TweetyDaBird/RefleXion-65/PCB/README.md

# RefleXion X65

# Change Log:
- v1.00 - Initial Prototype
  - Never released.

- v1.10 - First Release
  - Total redesign for onboard RP2040 MCU
  
- v1.15 - Second Prototype
  - Never Released.
  
- v1.20 - Second Release
  - Refactored USB footprint.
  - Refactored encoder footprints.
  - Refactored switch footprints with reinforced pads(larger via).
  - Added RGB selection from Glow to Per-Key with switch.
  - Added solder/jumper to select thumb RGB layout.
