TweetyDaBird/RefleXion-65/PCB/v1.20/bom/README.md

# Interactive BOM
To view the interactive bom, use the html preview link here: http://htmlpreview.github.io/?https://github.com/TweetyDaBird/RefleXion-65/blob/main/PCB/v1.20/bom/ibom.html
