TweetyDaBird/RefleXion-65/PCB/v1.20/_restore_backup_2026-09-21T10-17-14-011/RefleXion X65.kicad_pcb

## KiCad design PCB/v1.20/_restore_backup_2026-09-21T10-17-14-011/RefleXion X65.kicad_pcb (2026-11-10)

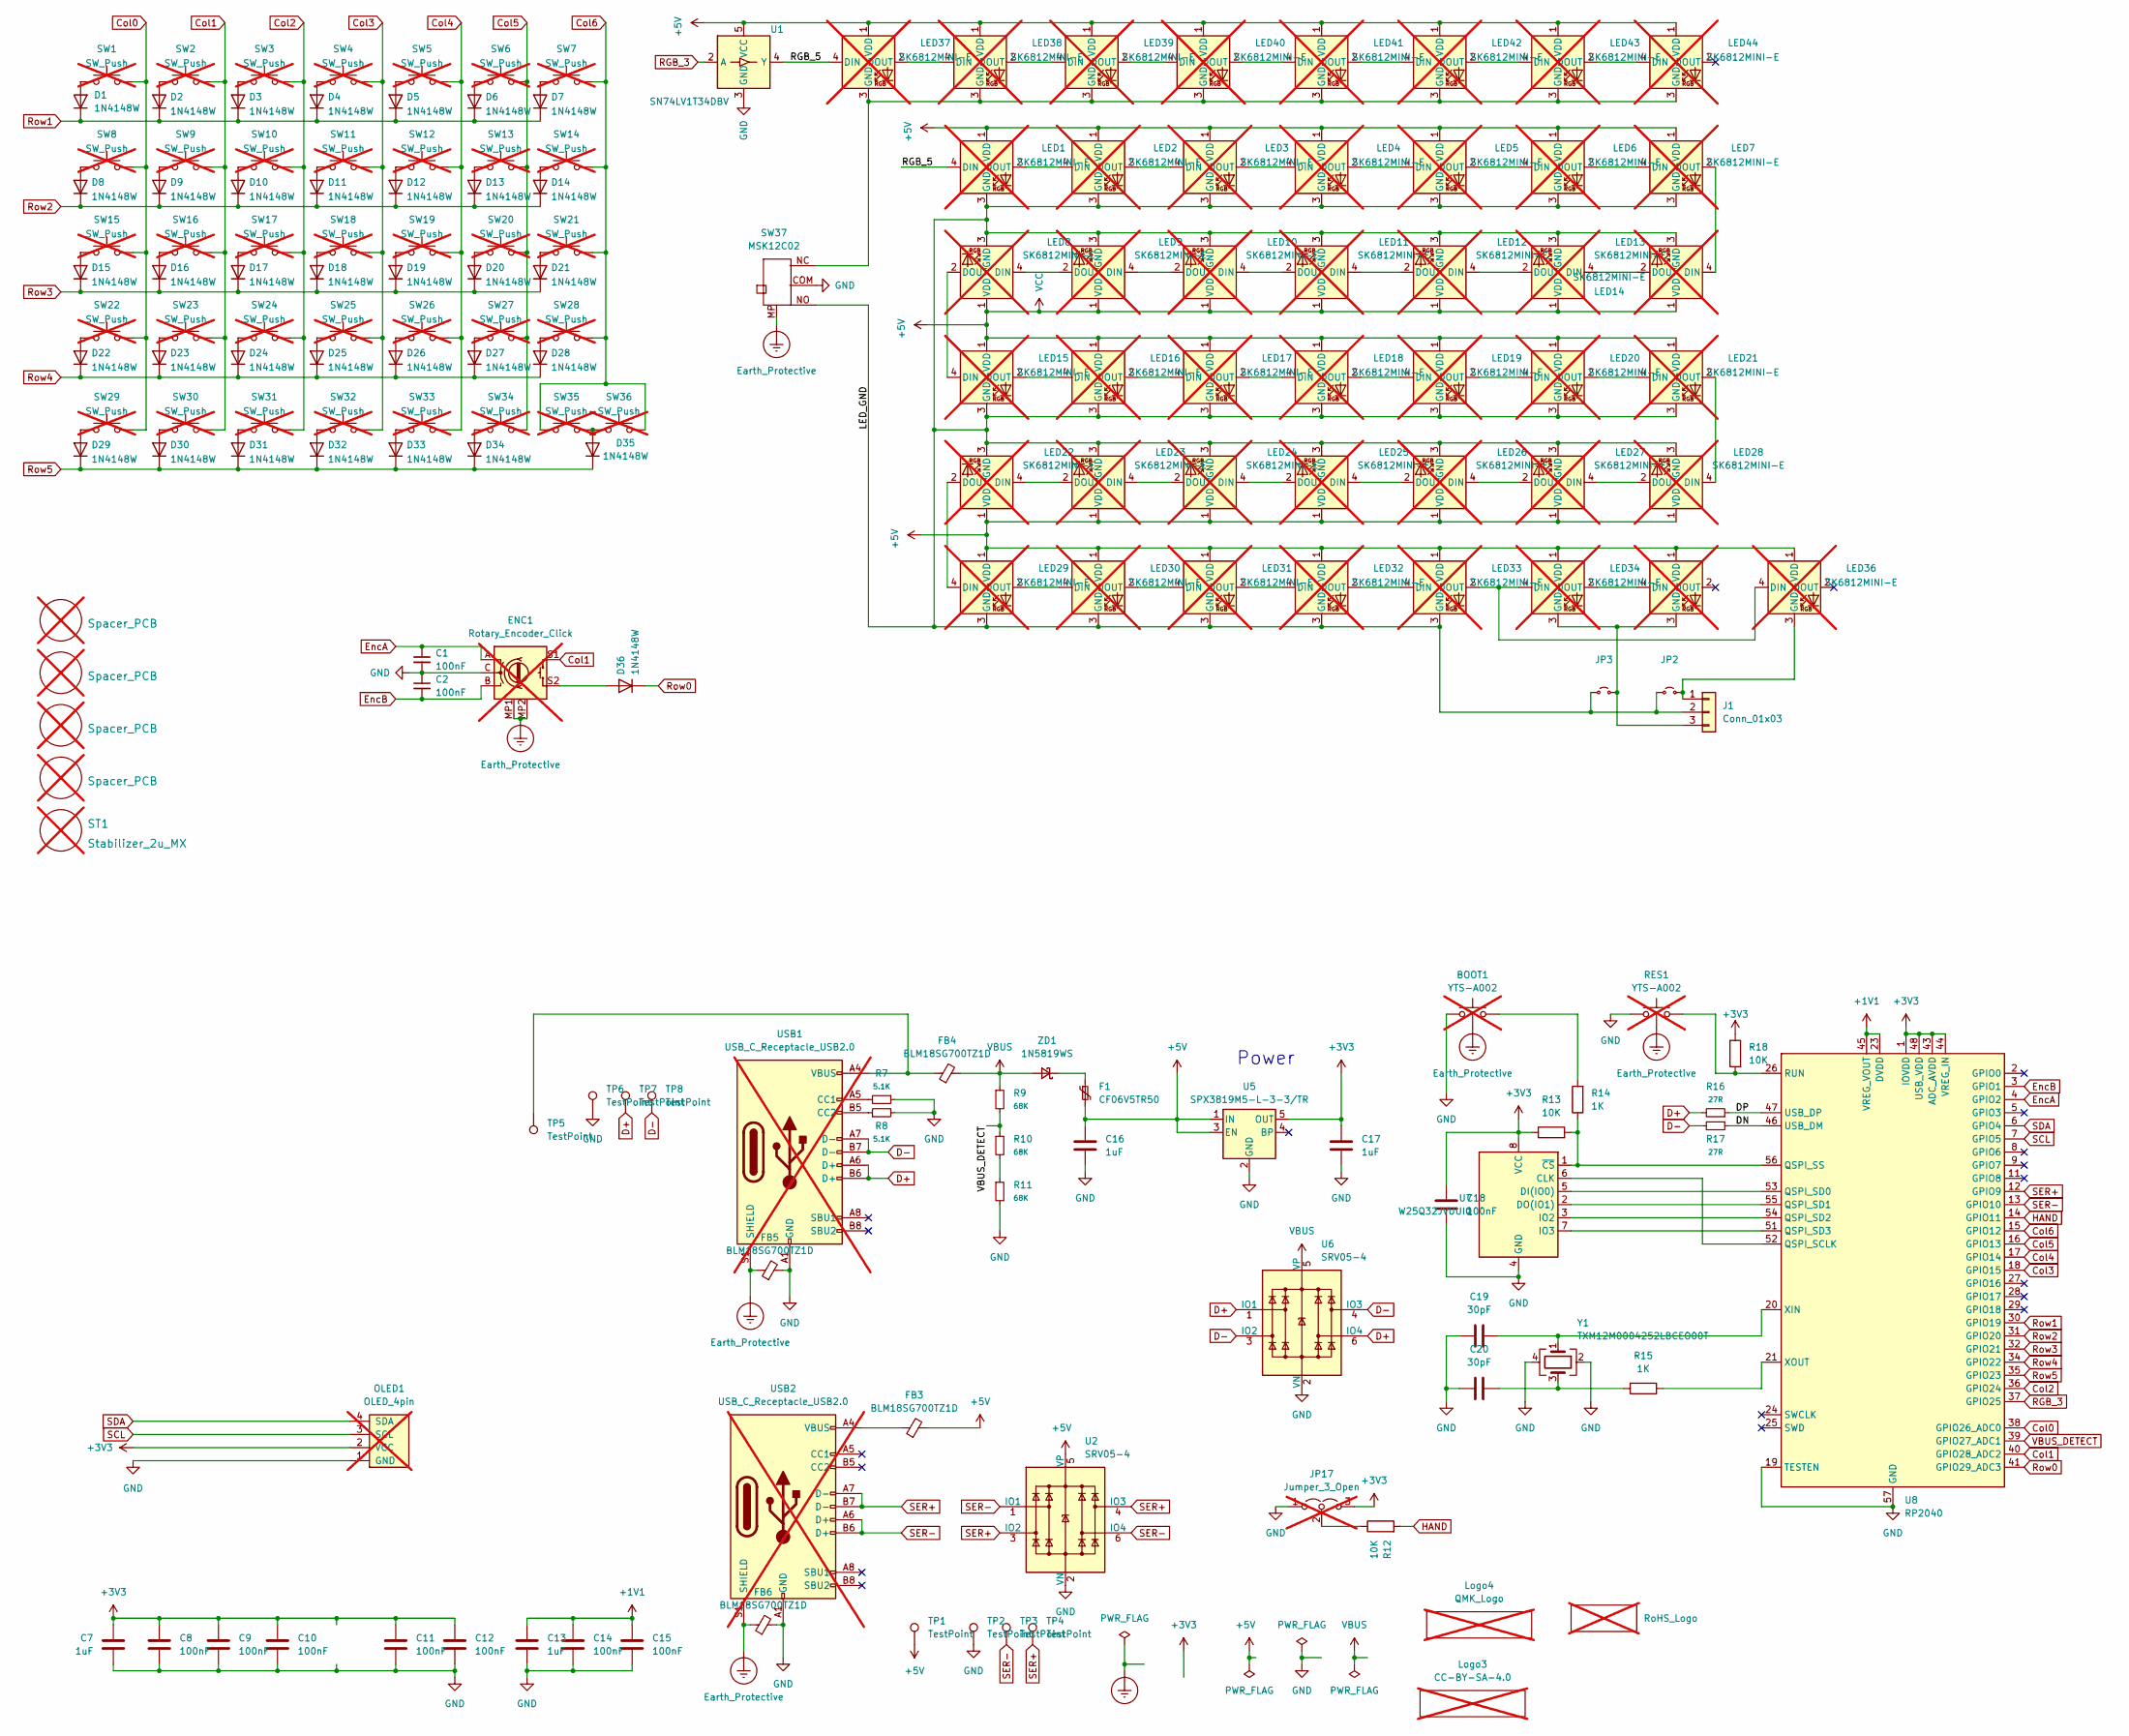
[picture p1: schematic RefleXion X65.kicad_sch]

Parts:
BOOT1: YTS-A002; LCSC C2910650; not fitted
C1, C2, C8, C9, C10, C11, C12, C14, C15, C18: 100nF; C_0402_1005Metric; LCSC C1525
C7, C13, C16, C17: 1uF; C_0402_1005Metric; LCSC C52923
C19, C20: 30pF; C_0402_1005Metric; LCSC C1570
D1, D2, D3, D4, D5, D6, D7, D8, D9, D10, D11, D12, D13, D14, D15, D16, D17, D18, D19, D20, D21, D22, D23, D24, D25, D26, D27, D28, D29, D30, D31, D32, D33, D34, D35, D36: 1N4148W; D_SOD-323_HandSoldering; LCSC C81598
ENC1: Rotary_Encoder_Click; Encoder_Alps_EC11E_Small; not fitted
F1: CF06V5TR50; R_0603_1608Metric; LCSC C163116
FB3, FB4, FB5, FB6: BLM18SG700TZ1D; C_0603_1608Metric_Pad1.08x0.95mm_HandSolder; LCSC C1002
H1, H2, H3, H4: Spacer_PCB; Spacer PCB hole; not fitted
J1: Conn_01x03; PinHeader_1x03_P1.27mm_Horizontal
JP2, JP3: Jumper_2_Small_Open; Jumper_min_v2
JP17: Jumper_3_Open; SolderJumper-3_open_mini; not fitted
LED1, LED2, LED3, LED4, LED5, LED6, LED7, LED8, LED9, LED10, LED11, LED12, LED13, LED14, LED15, LED16, LED17, LED18, LED19, LED20, LED21, LED22, LED23, LED24, LED25, LED26, LED27, LED28, LED29, LED30, LED31, LED32, LED33: SK6812MINI-E; MX_SK6812MINI-E_REVERSIBLE; not fitted
LED34, LED35, LED36, LED37, LED38, LED39, LED40, LED41, LED42, LED43, LED44: SK6812MINI-E; MX_SK6812MINI-E_REVERSIBLE_special; not fitted
Logo1: RoHS_Logo; RoHs; not fitted
Logo3: CC-BY-SA-4.0; CC_BY_SA_40_line; not fitted
Logo4: QMK_Logo; Powered_by_QMK; not fitted
OLED1: OLED_4pin; SSD1306-0.91-OLED-4pin-128x32 doublesided; not fitted
R7, R8: 5.1K; R_0402_1005Metric; LCSC C25905
R9, R10, R11: 68K; R_0402_1005Metric; LCSC C137947
R12, R13, R18: 10K; R_0402_1005Metric; LCSC C25744
R14, R15: 1K; R_0402_1005Metric; LCSC C11702
R16, R17: 27R; R_0402_1005Metric; LCSC C321419
RES1: YTS-A002; LCSC C2910650; not fitted
ST1: Stabilizer_2u_MX; Stabilizer_Cherry_MX_2.00u; not fitted
SW1, SW2, SW3, SW4, SW5, SW6, SW7, SW8, SW9, SW10, SW11, SW12, SW13, SW14, SW15, SW16, SW17, SW18, SW19, SW20, SW21, SW22, SW23, SW24, SW25, SW26, SW27, SW28, SW29, SW30, SW31, SW32, SW33, SW34, SW35, SW36: SW_Push; SW_MX_HotSwap_Reversible_reinforced; not fitted
SW37: MSK12C02
TP1, TP2, TP3, TP4, TP5, TP6, TP7, TP8: TestPoint; TestPoint_Pad_D1.0mm
U1: SN74LV1T34DBV; SOT-23-5; LCSC C100024
U2, U6: SRV05-4; SOT-23-6; LCSC C7420376
U5: SPX3819M5-L-3-3/TR; SOT-23-5; LCSC C9055
U7: W25Q32JVUUIQ; USON-8_4x3mm_P0.8mm; LCSC C2999380
U8: RP2040; QFN-56-1EP_7x7mm_P0.4mm_EP3.2x3.2mm_ThermalVias; LCSC C2040
USB1: USB_C_Receptacle_USB2.0; HRO_TYPE-C-31-M-12_double_sided; LCSC C963373; not fitted
USB2: USB_C_Receptacle_USB2.0; HRO_TYPE-C-31-M-12_double_sided_serial link; LCSC C963373; not fitted
Y1: TXM12M0004252LBCEO00T; Crystal_SMD_2520-4Pin_2.5x2.0mm; LCSC C284156
ZD1: 1N5819WS; D_SOD-323F; LCSC C191023

Connections:
+1V1: C13.1, C14.1, C15.1, U8.23 (DVDD), U8.45 (VREG_VOUT), U8.50 (DVDD)
+3V3: C7.1, C8.1, C9.1, C10.1, C11.1, C12.1, C17.1, C18.1, JP17.3 (B), OLED1.2 (VCC), R13.1, R18.1, U5.5 (OUT), U7.8 (VCC), U8.1 (IOVDD), U8.10 (IOVDD), U8.22 (IOVDD), U8.33 (IOVDD), U8.42 (IOVDD), U8.43 (ADC_AVDD), U8.44 (VREG_IN), U8.48 (USB_VDD), U8.49 (IOVDD)
+5V: C16.1, F1.2, FB3.2, LED1.1 (VDD), LED2.1 (VDD), LED3.1 (VDD), LED4.1 (VDD), LED5.1 (VDD), LED6.1 (VDD), LED7.1 (VDD), LED8.1 (VDD), LED9.1 (VDD), LED10.1 (VDD), LED11.1 (VDD), LED12.1 (VDD), LED13.1 (VDD), LED14.1 (VDD), LED15.1 (VDD), LED16.1 (VDD), LED17.1 (VDD), LED18.1 (VDD), LED19.1 (VDD), LED20.1 (VDD), LED21.1 (VDD), LED22.1 (VDD), LED23.1 (VDD), LED24.1 (VDD), LED25.1 (VDD), LED26.1 (VDD), LED27.1 (VDD), LED28.1 (VDD), LED29.1 (VDD), LED30.1 (VDD), LED31.1 (VDD), LED32.1 (VDD), LED33.1 (VDD), LED34.1 (VDD), LED35.1 (VDD), LED36.1 (VDD), LED37.1 (VDD), LED38.1 (VDD), LED39.1 (VDD), LED40.1 (VDD), LED41.1 (VDD), LED42.1 (VDD), LED43.1 (VDD), LED44.1 (VDD), TP1.1 (1_1), U1.5 (VCC), U2.5 (VP), U5.1 (IN), U5.3 (EN)
/DN: R17.1, U8.46 (USB_DM)
/DP: R16.1, U8.47 (USB_DP)
/LED_GND: J1.2, JP2.1 (A), JP3.1 (A), LED1.3 (GND), LED2.3 (GND), LED3.3 (GND), LED4.3 (GND), LED5.3 (GND), LED6.3 (GND), LED7.3 (GND), LED8.3 (GND), LED9.3 (GND), LED10.3 (GND), LED11.3 (GND), LED12.3 (GND), LED13.3 (GND), LED14.3 (GND), LED15.3 (GND), LED16.3 (GND), LED17.3 (GND), LED18.3 (GND), LED19.3 (GND), LED20.3 (GND), LED21.3 (GND), LED22.3 (GND), LED23.3 (GND), LED24.3 (GND), LED25.3 (GND), LED26.3 (GND), LED27.3 (GND), LED28.3 (GND), LED29.3 (GND), LED30.3 (GND), LED31.3 (GND), LED32.3 (GND), LED33.3 (GND), SW37.NO
/RGB_5: LED1.4 (DIN), LED37.4 (DIN), U1.4 (Y)
Col0: SW1.1, SW8.1, SW15.1, SW22.1, SW29.1, U8.38 (GPIO26_ADC0)
Col1: ENC1.S1, SW2.2, SW9.2, SW16.2, SW23.2, SW30.2, U8.40 (GPIO28_ADC2)
Col2: SW3.2, SW10.2, SW17.2, SW24.2, SW31.2, U8.36 (GPIO24)
Col3: SW4.2, SW11.2, SW18.2, SW25.2, SW32.2, U8.18 (GPIO15)
Col4: SW5.2, SW12.2, SW19.2, SW26.2, SW33.2, U8.17 (GPIO14)
Col5: SW6.2, SW13.2, SW20.2, SW27.2, SW34.2, U8.16 (GPIO13)
Col6: SW7.2, SW14.2, SW21.2, SW28.2, SW35.1, SW36.2, U8.15 (GPIO12)
D+: R16.2, TP7.1 (1_1), U6.1 (IO1), U6.6 (IO4), USB1.A6 (D+), USB1.B6 (D+)
D-: R17.2, TP8.1 (1_1), U6.3 (IO2), U6.4 (IO3), USB1.A7 (D-), USB1.B7 (D-)
Earth_Protective: BOOT1.3, ENC1.MP1 (GND), ENC1.MP2 (GND), FB5.1, FB6.1, RES1.3, SW37.MP (GND), USB1.S1 (SHIELD), USB2.S1 (SHIELD)
Enc1: D1.2 (A), SW1.2
Enc2: D7.2 (A), SW7.1
EncA: C1.1, ENC1.A, U8.4 (GPIO2)
EncB: C2.2, ENC1.B, U8.3 (GPIO1)
GND: BOOT1.2, C1.2, C2.1, C7.2, C8.2, C9.2, C10.2, C11.2, C12.2, C13.2, C14.2, C15.2, C16.2, C17.2, C18.2, C19.2, C20.2, ENC1.C, FB5.2, FB6.2, JP17.1 (A), OLED1.1 (GND), R7.1, R8.2, R11.2, RES1.1, SW37.COM, TP2.1 (1_1), TP6.1 (1_1), U1.3 (GND), U2.2 (VN), U5.2 (GND), U6.2 (VN), U7.4 (GND), U8.19 (TESTEN), U8.57 (GND), USB1.A1 (GND), USB1.A12 (GND), USB1.B1 (GND), USB1.B12 (GND), USB2.A1 (GND), USB2.A12 (GND), USB2.B1 (GND), USB2.B12 (GND), Y1.2, Y1.4
HAND: R12.2, U8.14 (GPIO11)
unnamed: BOOT1.1, R14.2
unnamed: C20.1, R15.2, Y1.3
unnamed: D2.2 (A), SW2.1
unnamed: D3.2 (A), SW3.1
unnamed: D4.2 (A), SW4.1
unnamed: D5.2 (A), SW5.1
unnamed: D6.2 (A), SW6.1
unnamed: D8.2 (A), SW8.2
unnamed: D9.2 (A), SW9.1
unnamed: D10.2 (A), SW10.1
unnamed: D11.2 (A), SW11.1
unnamed: D12.2 (A), SW12.1
unnamed: D13.2 (A), SW13.1
unnamed: D14.2 (A), SW14.1
unnamed: D15.2 (A), SW15.2
unnamed: D16.2 (A), SW16.1
unnamed: D17.2 (A), SW17.1
unnamed: D18.2 (A), SW18.1
unnamed: D19.2 (A), SW19.1
unnamed: D20.2 (A), SW20.1
unnamed: D21.2 (A), SW21.1
unnamed: D22.2 (A), SW22.2
unnamed: D23.2 (A), SW23.1
unnamed: D24.2 (A), SW24.1
unnamed: D25.2 (A), SW25.1
unnamed: D26.2 (A), SW26.1
unnamed: D27.2 (A), SW27.1
unnamed: D28.2 (A), SW28.1
unnamed: D29.2 (A), SW29.2
unnamed: D30.2 (A), SW30.1
unnamed: D31.2 (A), SW31.1
unnamed: D32.2 (A), SW32.1
unnamed: D33.2 (A), SW33.1
unnamed: D34.2 (A), SW34.1
unnamed: D35.2 (A), SW35.2, SW36.1
unnamed: D36.2 (A), ENC1.S2
unnamed: FB3.1, USB2.A4 (VBUS), USB2.A9 (VBUS), USB2.B4 (VBUS), USB2.B9 (VBUS)
unnamed: FB4.1, TP5.1 (1_1), USB1.A4 (VBUS), USB1.A9 (VBUS), USB1.B4 (VBUS), USB1.B9 (VBUS)
unnamed: J1.1, JP2.2 (B), LED36.3 (GND)
unnamed: J1.3, JP3.2 (B), LED34.3 (GND), LED35.3 (GND)
unnamed: JP17.2 (C), R12.1
unnamed: LED1.2 (DOUT), LED2.4 (DIN)
unnamed: LED2.2 (DOUT), LED3.4 (DIN)
unnamed: LED3.2 (DOUT), LED4.4 (DIN)
unnamed: LED4.2 (DOUT), LED5.4 (DIN)
unnamed: LED5.2 (DOUT), LED6.4 (DIN)
unnamed: LED6.2 (DOUT), LED7.4 (DIN)
unnamed: LED8.4 (DIN), LED9.2 (DOUT)
unnamed: LED10.4 (DIN), LED11.2 (DOUT)
unnamed: LED9.4 (DIN), LED10.2 (DOUT)
unnamed: LED11.4 (DIN), LED12.2 (DOUT)
unnamed: LED12.4 (DIN), LED13.2 (DOUT)
unnamed: LED13.4 (DIN), LED14.2 (DOUT)
unnamed: LED7.2 (DOUT), LED14.4 (DIN)
unnamed: LED8.2 (DOUT), LED15.4 (DIN)
unnamed: LED15.2 (DOUT), LED16.4 (DIN)
unnamed: LED16.2 (DOUT), LED17.4 (DIN)
unnamed: LED17.2 (DOUT), LED18.4 (DIN)
unnamed: LED18.2 (DOUT), LED19.4 (DIN)
unnamed: LED19.2 (DOUT), LED20.4 (DIN)
unnamed: LED20.2 (DOUT), LED21.4 (DIN)
unnamed: LED21.2 (DOUT), LED28.4 (DIN)
unnamed: LED22.4 (DIN), LED23.2 (DOUT)
unnamed: LED22.2 (DOUT), LED29.4 (DIN)
unnamed: LED23.4 (DIN), LED24.2 (DOUT)
unnamed: LED24.4 (DIN), LED25.2 (DOUT)
unnamed: LED25.4 (DIN), LED26.2 (DOUT)
unnamed: LED26.4 (DIN), LED27.2 (DOUT)
unnamed: LED27.4 (DIN), LED28.2 (DOUT)
unnamed: LED29.2 (DOUT), LED30.4 (DIN)
unnamed: LED30.2 (DOUT), LED31.4 (DIN)
unnamed: LED31.2 (DOUT), LED32.4 (DIN)
unnamed: LED32.2 (DOUT), LED33.4 (DIN)
unnamed: LED33.2 (DOUT), LED34.4 (DIN), LED36.4 (DIN)
unnamed: LED34.2 (DOUT), LED35.4 (DIN)
unnamed: LED37.2 (DOUT), LED38.4 (DIN)
unnamed: LED37.3 (GND), LED38.3 (GND), LED39.3 (GND), LED40.3 (GND), LED41.3 (GND), LED42.3 (GND), LED43.3 (GND), LED44.3 (GND), SW37.NC
unnamed: LED38.2 (DOUT), LED39.4 (DIN)
unnamed: LED39.2 (DOUT), LED40.4 (DIN)
unnamed: LED40.2 (DOUT), LED41.4 (DIN)
unnamed: LED41.2 (DOUT), LED42.4 (DIN)
unnamed: LED42.2 (DOUT), LED43.4 (DIN)
unnamed: LED43.2 (DOUT), LED44.4 (DIN)
unnamed: R10.2, R11.1
unnamed: U7.6 (CLK), U8.52 (QSPI_SCLK)
unnamed: U7.5 (DI(IO0)), U8.53 (QSPI_SD0)
unnamed: U7.2 (DO(IO1)), U8.55 (QSPI_SD1)
unnamed: U7.3 (IO2), U8.54 (QSPI_SD2)
unnamed: U7.7 (IO3), U8.51 (QSPI_SD3)
unnamed: R13.2, R14.1, U7.1 (~CS), U8.56 (QSPI_SS)
unnamed: R18.2, RES1.2, U8.26 (RUN)
unnamed: C19.1, U8.20 (XIN), Y1.1
unnamed: R15.1, U8.21 (XOUT)
unnamed: R7.2, USB1.A5 (CC1)
unnamed: R8.1, USB1.B5 (CC2)
unnamed: F1.1, ZD1.1 (K)
RGB_3: U1.2 (A), U8.37 (GPIO25)
Row0: D36.1 (K), U8.41 (GPIO29_ADC3)
Row1: D1.1 (K), D2.1 (K), D3.1 (K), D4.1 (K), D5.1 (K), D6.1 (K), D7.1 (K), U8.30 (GPIO19)
Row2: D8.1 (K), D9.1 (K), D10.1 (K), D11.1 (K), D12.1 (K), D13.1 (K), D14.1 (K), U8.31 (GPIO20)
Row3: D15.1 (K), D16.1 (K), D17.1 (K), D18.1 (K), D19.1 (K), D20.1 (K), D21.1 (K), U8.32 (GPIO21)
Row4: D22.1 (K), D23.1 (K), D24.1 (K), D25.1 (K), D26.1 (K), D27.1 (K), D28.1 (K), U8.34 (GPIO22)
Row5: D29.1 (K), D30.1 (K), D31.1 (K), D32.1 (K), D33.1 (K), D34.1 (K), D35.1 (K), U8.35 (GPIO23)
SCL: OLED1.3 (SCL), U8.7 (GPIO5)
SDA: OLED1.4 (SDA), U8.6 (GPIO4)
SER+: TP4.1 (1_1), U2.3 (IO2), U2.4 (IO3), U8.12 (GPIO9), USB2.A7 (D-), USB2.B7 (D-)
SER-: TP3.1 (1_1), U2.1 (IO1), U2.6 (IO4), U8.13 (GPIO10), USB2.A6 (D+), USB2.B6 (D+)
VBUS: FB4.2, R9.1, U6.5 (VP), ZD1.2 (A)
VBUS_DETECT: R9.2, R10.1, U8.39 (GPIO27_ADC1)

Notes on the sheet:
Power

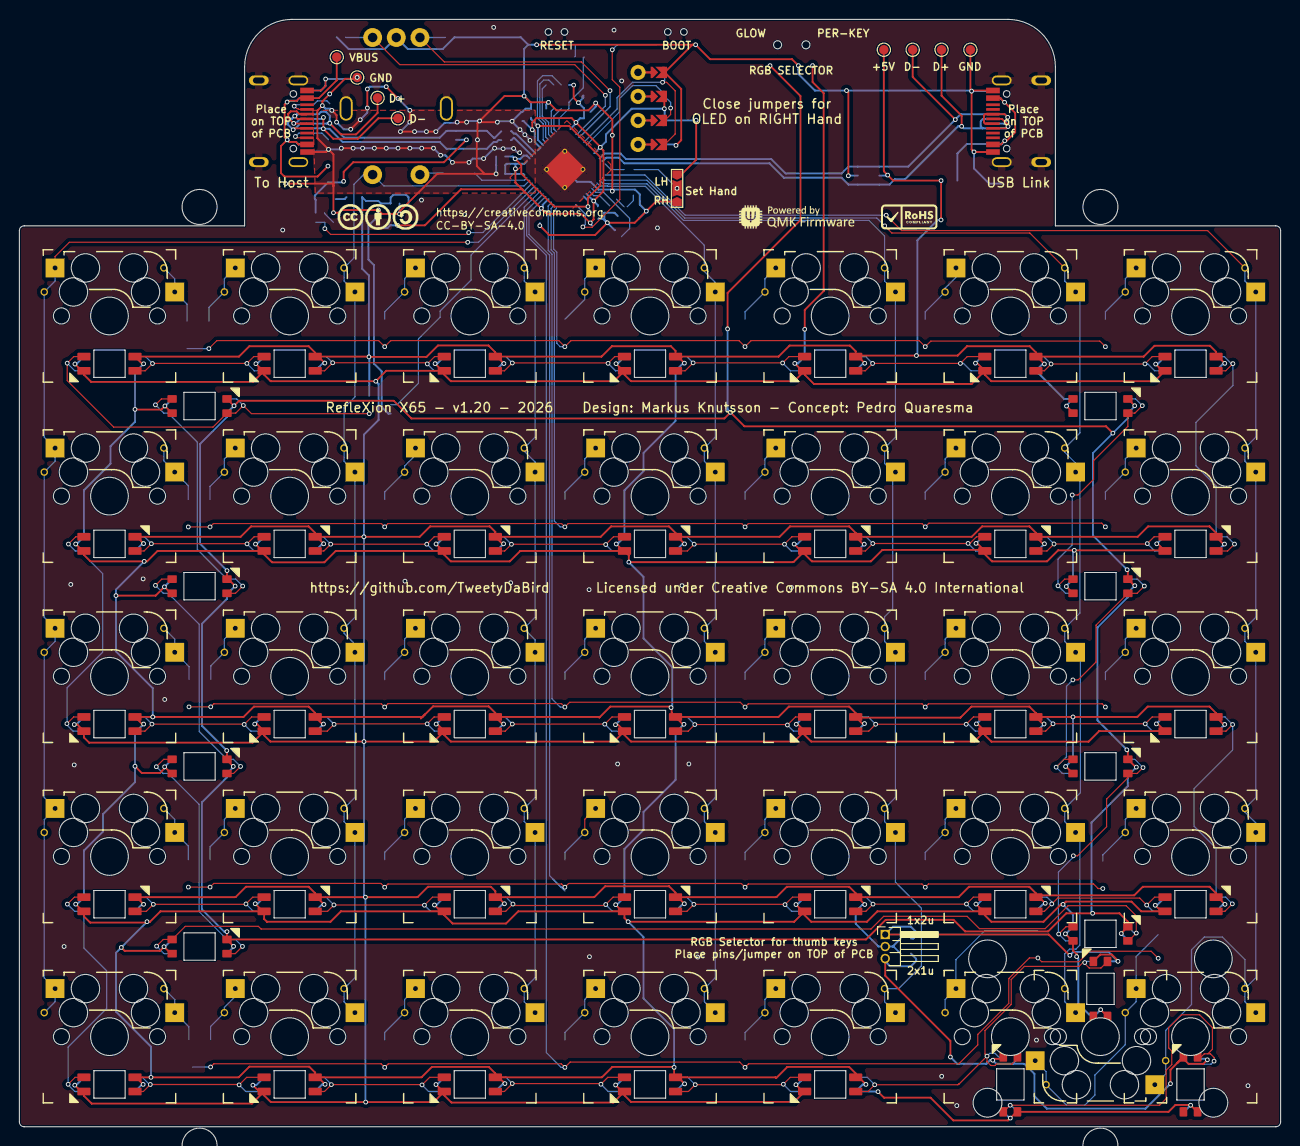
[picture p2: board RefleXion X65.kicad_pcb from above]

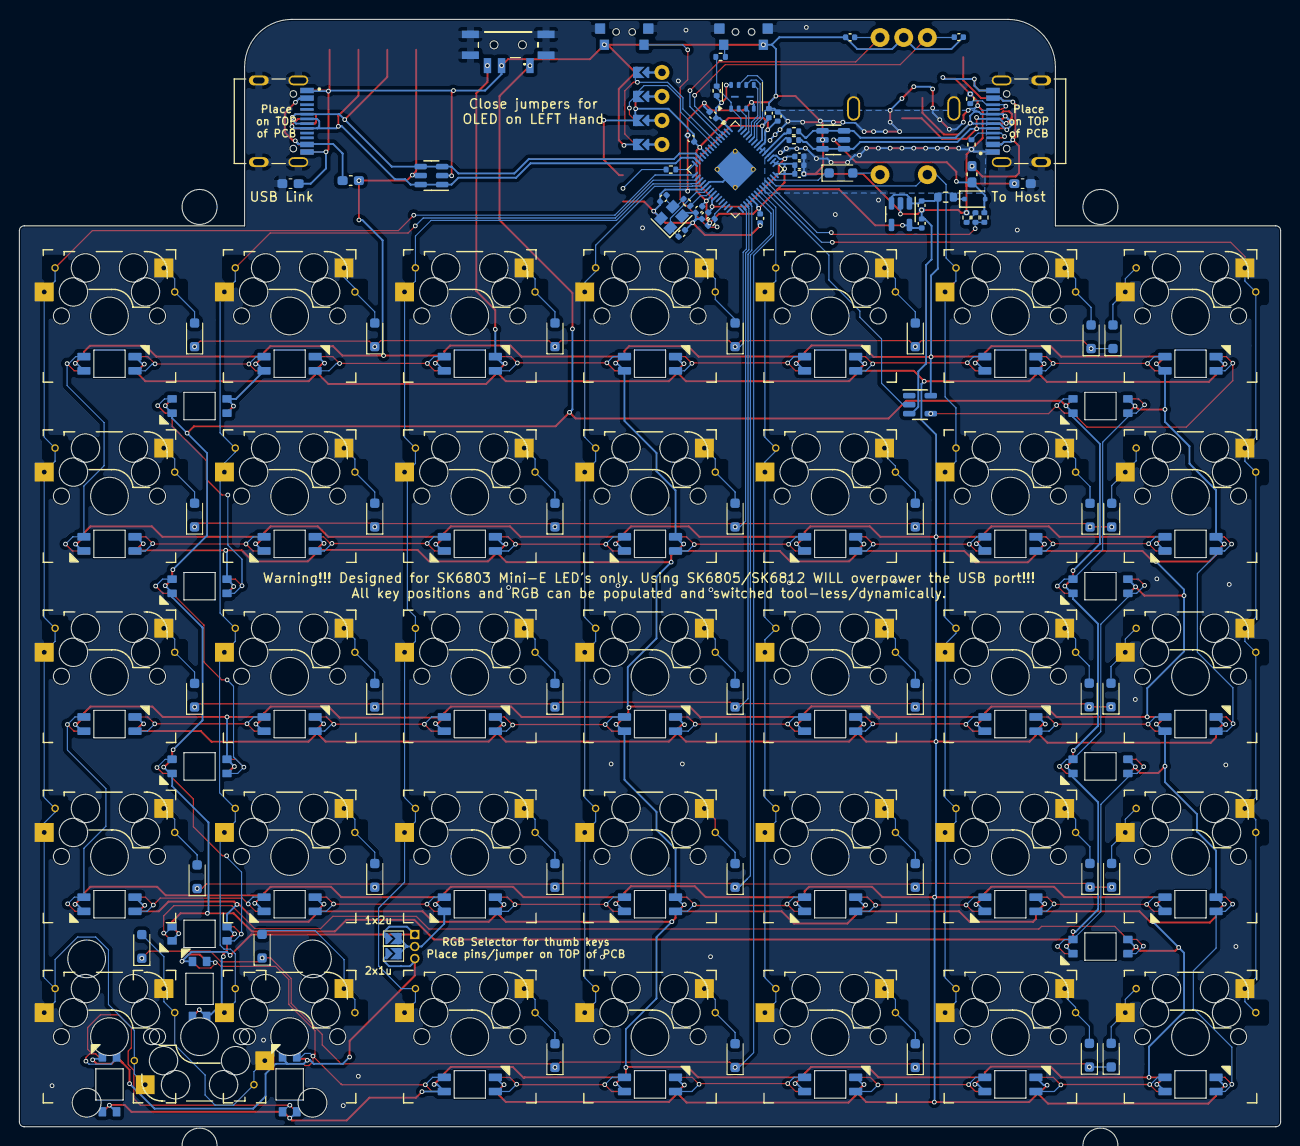
[picture p3: board RefleXion X65.kicad_pcb from below]

Board: 2 copper layers, 133.4 x 117.1 mm, 184 parts (84 on the bottom side), 132 nets.
