TweetyDaBird/RefleXion-65/(notices)

Notices in the files:
Plate/Front Plate - Blank/X65 Front Plate.kicad_sch:
Licensed under Creative Commons BY-SA 4.0 International
Plate/Front Plate - Blank/X65 Front Plate.kicad_pcb:
https://github.com/TweetyDaBird - Licensed under Creative Commons BY-SA 4.0 International
